botaneta/All-in-one-diybms/README.md

Modificación del proyecto original diyBms de Stuart Pittaway https://github.com/stuartpittaway/diyBMSv4<br>
Integración del módulo 490All-in-one y placa balanceadora en una sola pcb, con capacidad de balanceo de hasta 1.5A
