botaneta/All-in-one-diybms/Imagenes/photo_2024-06-24_20-07-30.jpg

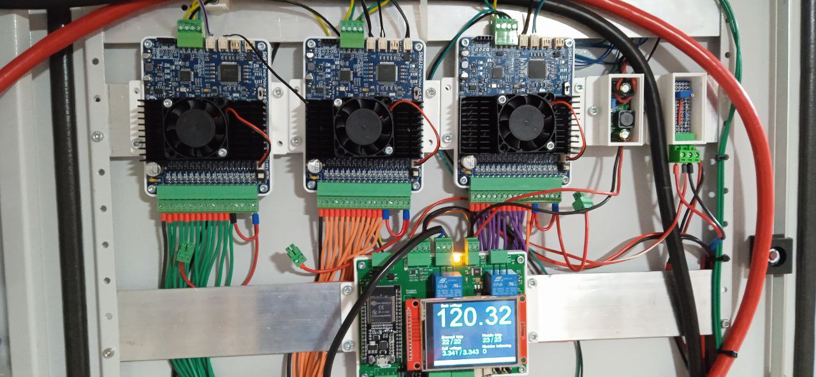
Imagenes/photo_2024-06-24_20-07-30.jpg
