botaneta/All-in-one-diybms/Soporte_3D/marco_all_in_one_1_5Abalancer.stl

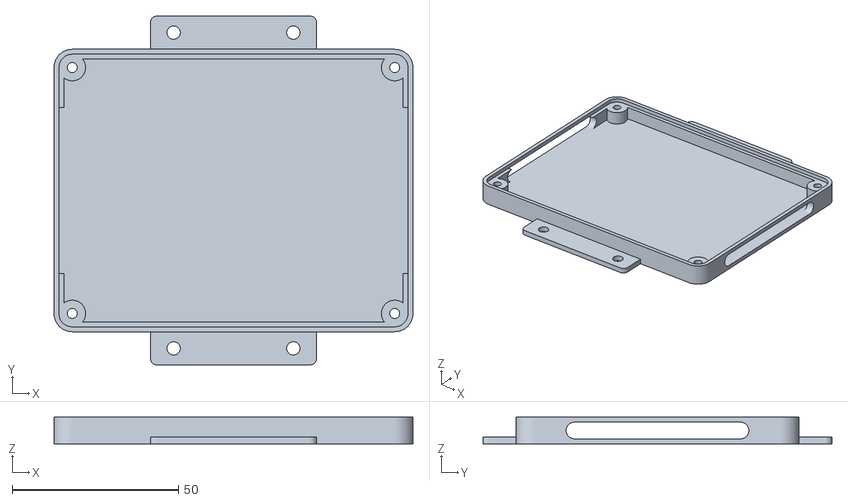
[picture p9: CAD file, 2024-06-24]
Soporte_3D/marco_all_in_one_1_5Abalancer.stl
108.0 x 105.0 x 8.00
