botaneta/All-in-one-diybms/(list of files, drawings)

Other design files:
KiCad_pcb/freerouting.dsn
