botaneta/All-in-one-diybms/KiCad_pcb/Module_16S.kicad_sch

## KiCad design KiCad_pcb/Module_16S.kicad_sch (2024-06-24)

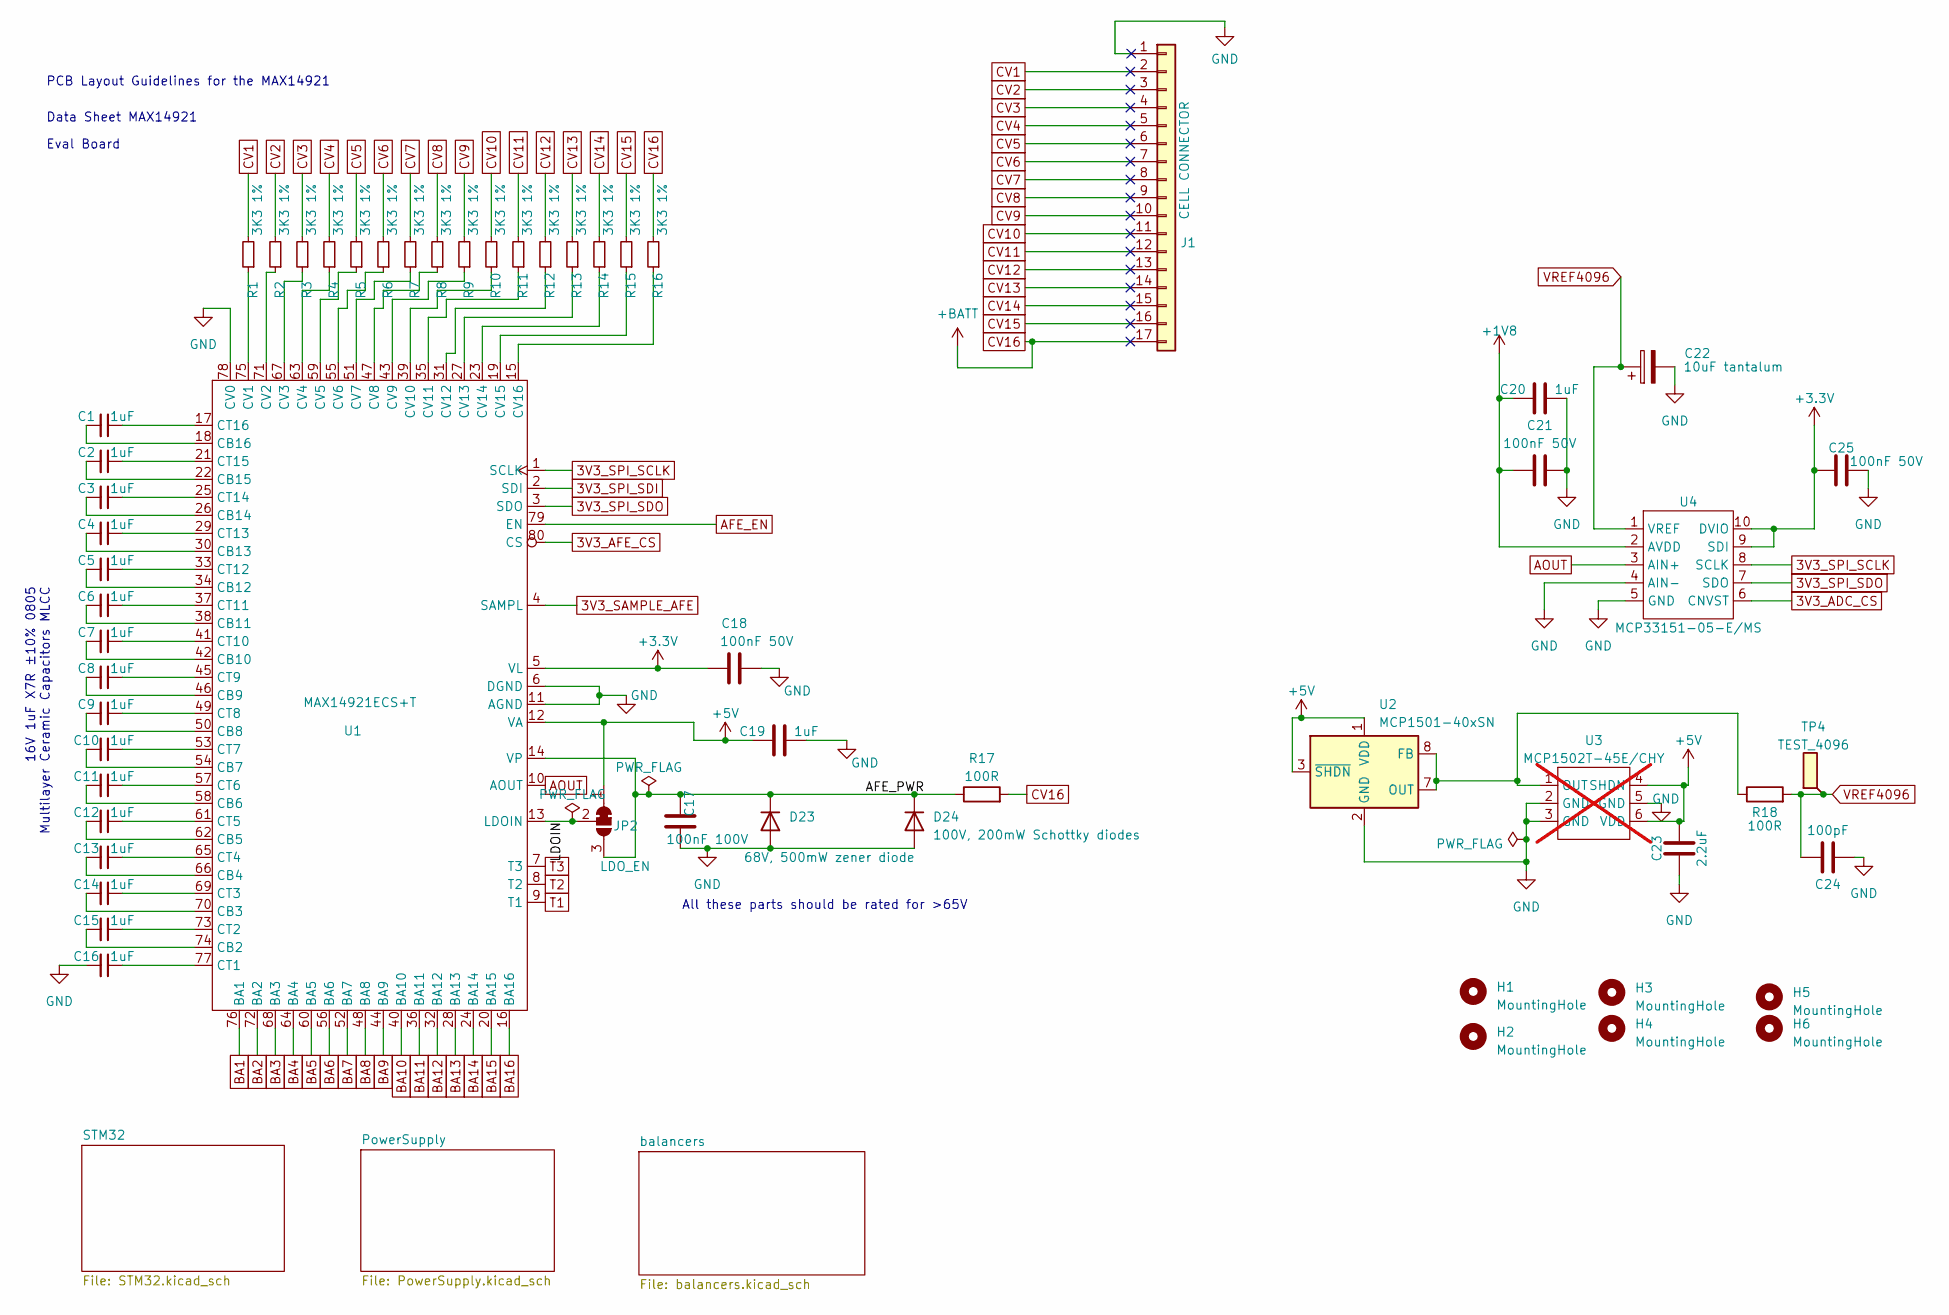
[picture p10: schematic Module_16S.kicad_sch]

Parts:
C1, C2, C3, C4, C5, C6, C7, C8, C9, C10, C11, C12, C13, C14, C15, C16, C19, C20: 1uF; C_0805_2012Metric; PartNumber CL21B105KBFNNNE; LCSCStockCode C28323
C17: 100nF 100V; C_0805_2012Metric; PartNumber CL21B104KCFNNNE; LCSCStockCode C28233
C18, C21, C25: 100nF 50V; C_0603_1608Metric; PartNumber CC0603KRX7R9BB104; LCSCStockCode C14663
C22: 10uF tantalum; CP_EIA-3216-18_Kemet-A; PartNumber TAJA106K016RNJ; LCSCStockCode C7171
C23: 2.2uF; C_0603_1608Metric; PartNumber CL10A225KO8NNNC; LCSCStockCode C23630
C24: 100pF; C_0603_1608Metric; PartNumber CL10C101JB8NNNC; LCSCStockCode C14858
D23: 68V, 500mW zener diode; D_SOD-123; PartNumber MMSZ5266BT1G; LCSCStockCode C242416
D24: 100V, 200mW Schottky diodes; D_SOD-123; PartNumber BAT46W-7-F; LCSCStockCode C83152
H1, H2: MountingHole; MountingHole_3.2mm_M3_DIN965_Pad
H3, H4, H5, H6: MountingHole; MountingHole_3.2mm_M3_ISO7380_Pad
J1: CELL CONNECTOR; WJ15EDGRC-3.81-17P; PartNumber WJ15EDGRC-3.81-17P; LCSCStockCode C489980
JP2: LDO_EN; SolderJumper-3_P1.3mm_Bridged12_RoundedPad1.0x1.5mm_NumberL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
R1, R2, R3, R4, R5, R6, R7, R8, R9, R10, R11, R12, R13, R14, R15, R16: 3K3 1%; R_0603_1608Metric; PartNumber 0603WAF3301T5E; LCSCStockCode C22978
R17, R18: 100R; R_0603_1608Metric; PartNumber 0603WAF1000T5E; LCSCStockCode C22775
TP4: TEST_4096; TestPoint_Pad_1.5x1.5mm
U1: MAX14921ECS+T; TQFP-80_12x12mm_P0.5mm; PartNumber MAX14921ECS+T; LCSCStockCode C2932577
U2: MCP1501-40xSN; SOIC-8_3.9x4.9mm_P1.27mm; PartNumber MCP1501-40E/SN; LCSCStockCode C1575589
U3: MCP1502T-45E/CHY; SOT-23-6; PartNumber MCP1502T-45E/CHY; not fitted
U4: MCP33151-05-E/MS; MSOP-10_3x3mm_P0.5mm; PartNumber MCP33151-05-E/MS; LCSCStockCode C635984

Connections:
3V3_ADC_CS: U4.6 (CNVST)
3V3_AFE_CS: U1.80 (CS)
3V3_SAMPLE_AFE: U1.4 (SAMPL)
3V3_SPI_SCLK: U1.1 (SCLK), U4.8 (SCLK)
3V3_SPI_SDI: U1.2 (SDI)
3V3_SPI_SDO: U1.3 (SDO), U4.7 (SDO)
+1V8: C20.1, C21.1, U4.2 (AVDD)
+3.3V: C18.1, C25.1, U1.5 (VL), U4.9 (SDI), U4.10 (DVIO)
+5V: C19.1, C23.2, JP2.1 (A), U1.12 (VA), U2.1 (VDD), U2.3 (~SHDN), U3.4 (SHDN), U3.6 (VDD)
+BATT: J1.17, R16.2, R17.2
AFE_EN: U1.79 (EN)
AFE_PWR: C17.1, D23.1 (K), D24.1 (K), JP2.3 (B), R17.1, U1.14 (VP)
AOUT: U1.10 (AOUT), U4.3 (AIN+)
BA1: U1.76 (BA1)
BA2: U1.72 (BA2)
BA3: U1.68 (BA3)
BA4: U1.64 (BA4)
BA5: U1.60 (BA5)
BA6: U1.56 (BA6)
BA7: U1.52 (BA7)
BA8: U1.48 (BA8)
BA9: U1.44 (BA9)
BA10: U1.40 (BA10)
BA11: U1.36 (BA11)
BA12: U1.32 (BA12)
BA13: U1.28 (BA13)
BA14: U1.24 (BA14)
BA15: U1.20 (BA15)
BA16: U1.16 (BA16)
CV1: J1.2, R1.2
CV2: J1.3, R2.2
CV3: J1.4, R3.2
CV4: J1.5, R4.2
CV5: J1.6, R5.2
CV6: J1.7, R6.2
CV7: J1.8, R7.2
CV8: J1.9, R8.2
CV9: J1.10, R9.2
CV10: J1.11, R10.2
CV11: J1.12, R11.2
CV12: J1.13, R12.2
CV13: J1.14, R13.2
CV14: J1.15, R14.2
CV15: J1.16, R15.2
GND: C16.2, C17.2, C18.2, C19.2, C20.2, C21.2, C22.2, C23.1, C24.1, C25.2, D23.2 (A), D24.2 (A), J1.1, U1.6 (DGND), U1.11 (AGND), U1.78 (CV0), U2.2 (GND), U2.4 (GND), U2.5 (GND), U2.6 (GND), U3.2 (GND), U3.3 (GND), U3.5 (GND), U4.4 (AIN-), U4.5 (GND)
LDOIN: JP2.2 (C), U1.13 (LDOIN)
unnamed: C1.1, U1.17 (CT16)
unnamed: C1.2, U1.18 (CB16)
unnamed: C2.1, U1.21 (CT15)
unnamed: C2.2, U1.22 (CB15)
unnamed: C3.1, U1.25 (CT14)
unnamed: C3.2, U1.26 (CB14)
unnamed: C4.1, U1.29 (CT13)
unnamed: C4.2, U1.30 (CB13)
unnamed: C5.1, U1.33 (CT12)
unnamed: C5.2, U1.34 (CB12)
unnamed: C6.1, U1.37 (CT11)
unnamed: C6.2, U1.38 (CB11)
unnamed: C7.1, U1.41 (CT10)
unnamed: C7.2, U1.42 (CB10)
unnamed: C8.1, U1.45 (CT9)
unnamed: C8.2, U1.46 (CB9)
unnamed: C9.1, U1.49 (CT8)
unnamed: C9.2, U1.50 (CB8)
unnamed: C10.1, U1.53 (CT7)
unnamed: C10.2, U1.54 (CB7)
unnamed: C11.1, U1.57 (CT6)
unnamed: C11.2, U1.58 (CB6)
unnamed: C12.1, U1.61 (CT5)
unnamed: C12.2, U1.62 (CB5)
unnamed: C13.1, U1.65 (CT4)
unnamed: C13.2, U1.66 (CB4)
unnamed: C14.1, U1.69 (CT3)
unnamed: C14.2, U1.70 (CB3)
unnamed: C15.1, U1.73 (CT2)
unnamed: C15.2, U1.74 (CB2)
unnamed: C16.1, U1.77 (CT1)
unnamed: R1.1, U1.75 (CV1)
unnamed: R2.1, U1.71 (CV2)
unnamed: R3.1, U1.67 (CV3)
unnamed: R4.1, U1.63 (CV4)
unnamed: R5.1, U1.59 (CV5)
unnamed: R6.1, U1.55 (CV6)
unnamed: R7.1, U1.51 (CV7)
unnamed: R8.1, U1.47 (CV8)
unnamed: R9.1, U1.43 (CV9)
unnamed: R10.1, U1.39 (CV10)
unnamed: R11.1, U1.35 (CV11)
unnamed: R12.1, U1.31 (CV12)
unnamed: R13.1, U1.27 (CV13)
unnamed: R14.1, U1.23 (CV14)
unnamed: R15.1, U1.19 (CV15)
unnamed: R16.1, U1.15 (CV16)
unnamed: R18.1, U2.7 (OUT), U2.8 (FB), U3.1 (OUT)
T1: U1.9 (T1)
T2: U1.8 (T2)
T3: U1.7 (T3)
VREF4096: C22.1, C24.2, R18.2, TP4.1, U4.1 (VREF)

Notes on the sheet:
All these parts should be rated for >65V
Eval Board
16V 1uF X7R ±10% 0805 Multilayer Ceramic Capacitors MLCC
Data Sheet MAX14921
PCB Layout Guidelines for the MAX14921
