botaneta/All-in-one-diybms/KiCad_pcb/PowerSupply.kicad_sch

## KiCad design KiCad_pcb/PowerSupply.kicad_sch (2024-06-24)

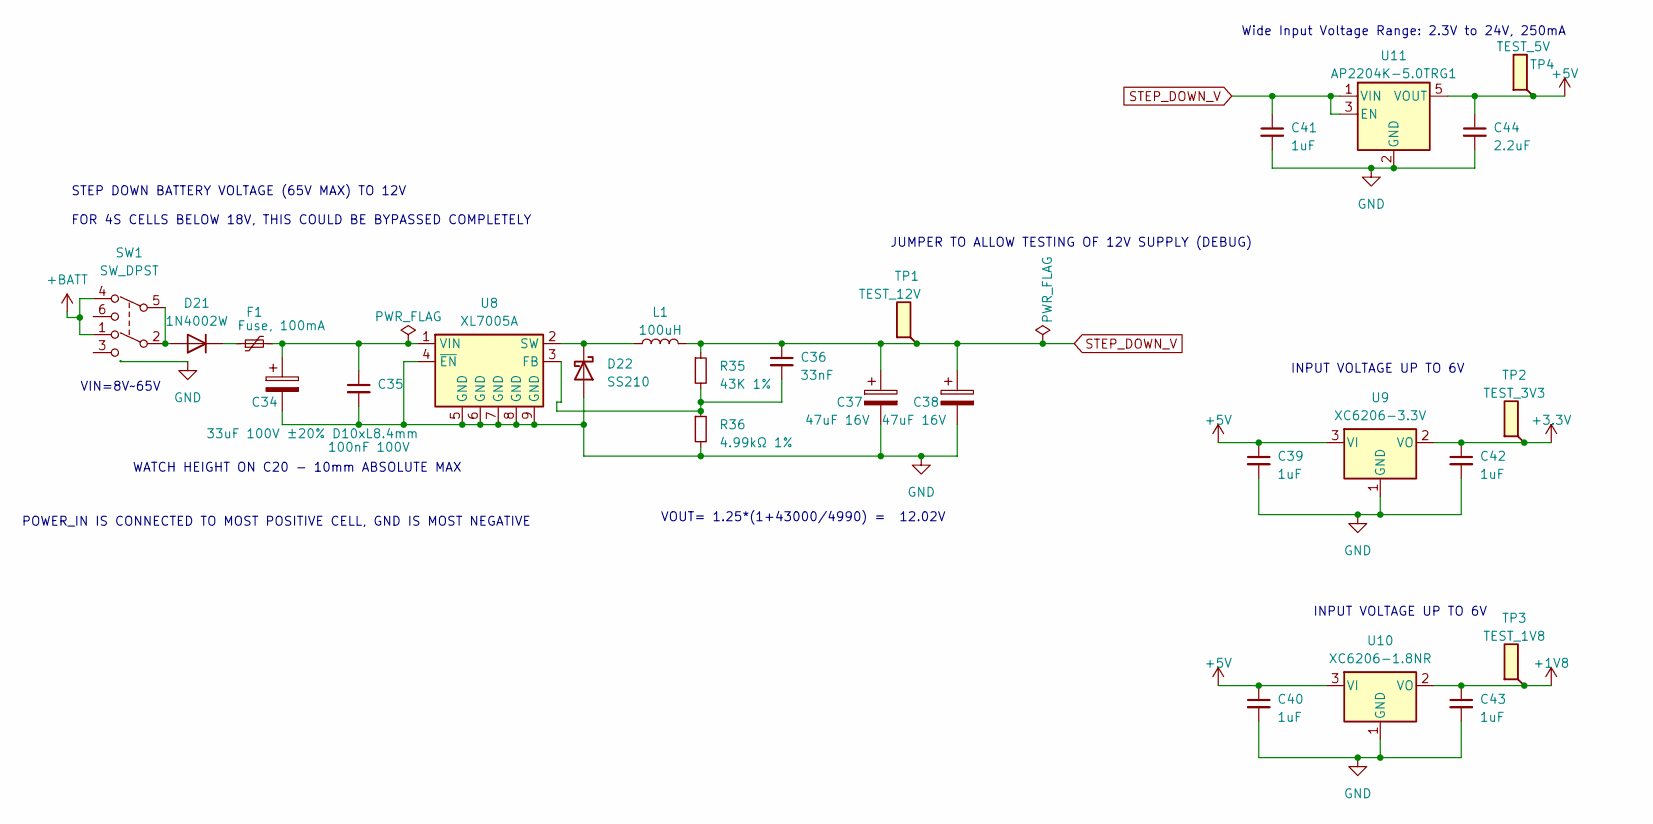
[picture p11: schematic PowerSupply.kicad_sch]

Parts:
C34: 33uF 100V ±20% D10xL8.4mm; CP_Elec_10x7.9; PartNumber VK7E0842A330MV; LCSCStockCode C486954
C35: 100nF 100V; C_0805_2012Metric; PartNumber CL21B104KCFNNNE; LCSCStockCode C28233
C36: 33nF; C_0603_1608Metric; PartNumber CC0603KRX7R8BB333; LCSCStockCode C113810
C37, C38: 47uF 16V; CP_Elec_5x5.4; PartNumber RVT1C470M0505; LCSCStockCode C3337
C39, C40, C41, C42, C43: 1uF; C_0805_2012Metric; PartNumber CL21B105KBFNNNE; LCSCStockCode C28323
C44: 2.2uF; C_0603_1608Metric; PartNumber CL10A225KO8NNNC; LCSCStockCode C23630
D21: 1N4002W; D_SOD-123F; PartNumber 1N4002W; LCSCStockCode C169542
D22: SS210; D_SMA; PartNumber SS210; LCSCStockCode C432298
F1: Fuse, 100mA; Fuse_Bourns_MF-RHT100; PartNumber JK250-100U; LCSCStockCode C2680606
L1: 100uH; L_Changjiang_FNR5020S; PartNumber SMNR5020-101MT; LCSCStockCode C135286
R35: 43K 1%; R_0603_1608Metric; PartNumber 0603WAF4302T5E; LCSCStockCode C23172
R36: 4.99kΩ 1%; R_0603_1608Metric; PartNumber 0603WAF4991T5E; LCSCStockCode C23046
SW1: SW_DPST; SW_Push_2P2T_Toggle_G_swicht; PartNumber PS-7054DVB-6PL; LCSCStockCode C22363819
TP1: TEST_12V; TestPoint_Pad_1.5x1.5mm
TP2: TEST_3V3; TestPoint_Pad_1.5x1.5mm
TP3: TEST_1V8; TestPoint_Pad_1.5x1.5mm
TP4: TEST_5V; TestPoint_Pad_1.5x1.5mm
U8: XL7005A; SOIC-8-1EP_3.9x4.9mm_P1.27mm_EP2.29x3mm; PartNumber XL7005A; LCSCStockCode C50848
U9: XC6206-3.3V; SOT-23-3; PartNumber XC6206-3.3V; LCSCStockCode C2891841
U10: XC6206-1.8NR; SOT-23-3; PartNumber XC6206-1.8NR; LCSCStockCode C2984870
U11: AP2204K-5.0TRG1; SOT-23-5; PartNumber AP2204K-5.0TRG1; LCSCStockCode C112031

Connections:
+1V8: C43.1, TP3.1, U10.2 (VO)
+3.3V: C42.1, TP2.1, U9.2 (VO)
+5V: C39.1, C40.1, C44.1, TP4.1, U9.3 (VI), U10.3 (VI), U11.5 (VOUT)
+BATT: SW1.1, SW1.4
GND: C34.2, C35.2, C37.2, C38.2, C39.2, C40.2, C41.2, C42.2, C43.2, C44.2, D22.2 (A), R36.2, U8.4 (~EN), U8.5 (GND), U8.6 (GND), U8.7 (GND), U8.8 (GND), U8.9 (GND), U9.1 (GND), U10.1 (GND), U11.2 (GND)
unnamed: C34.1, C35.1, F1.2, U8.1 (VIN)
unnamed: C36.2, R35.2, R36.1, U8.3 (FB)
unnamed: D21.1 (K), F1.1
unnamed: D21.2 (A), SW1.2, SW1.5
unnamed: D22.1 (K), L1.1, U8.2 (SW)
STEP_DOWN_V: C36.1, C37.1, C38.1, C41.1, L1.2, R35.1, TP1.1, U11.1 (VIN), U11.3 (EN)

Notes on the sheet:
INPUT VOLTAGE UP TO 6V
POWER_IN IS CONNECTED TO MOST POSITIVE CELL, GND IS MOST NEGATIVE
JUMPER TO ALLOW TESTING OF 12V SUPPLY (DEBUG)
VIN=8V~65V
STEP DOWN BATTERY VOLTAGE (65V MAX) TO 12V FOR 4S CELLS BELOW 18V, THIS COULD BE BYPASSED COMPLETELY
WATCH HEIGHT ON C20 - 10mm ABSOLUTE MAX
VOUT= 1.25*(1+43000/4990) = 12.02V
Wide Input Voltage Range: 2.3V to 24V, 250mA
