botaneta/All-in-one-diybms/KiCad_pcb/STM32.kicad_sch

## KiCad design KiCad_pcb/STM32.kicad_sch (2024-06-24)

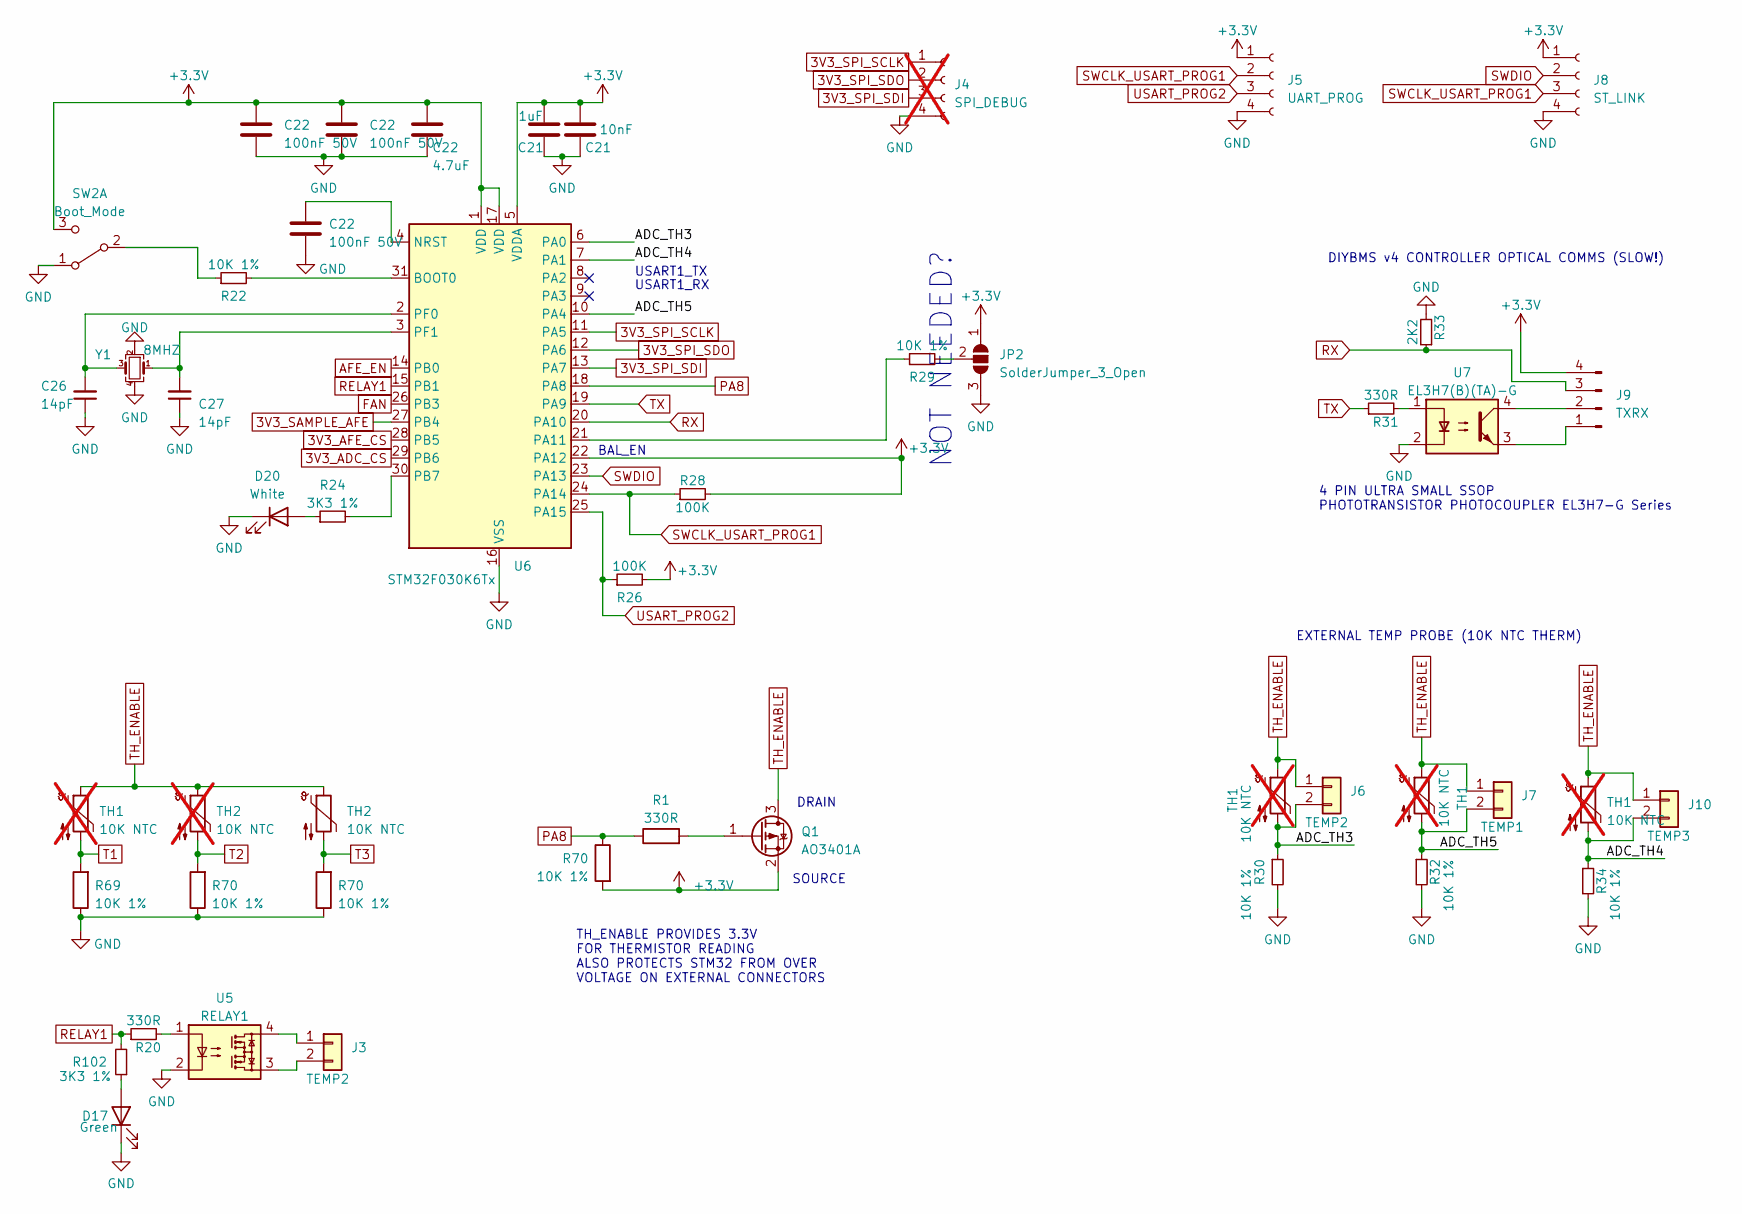
[picture p12: schematic STM32.kicad_sch]

Parts:
C21: 1uF; C_0805_2012Metric; PartNumber CL21B105KBFNNNE; LCSCStockCode C28323
C22: 100nF 50V; C_0603_1608Metric; PartNumber CC0603KRX7R9BB104; LCSCStockCode C14663
C26, C27: 14pF; C_0805_2012Metric; PartNumber CC0805JRNPO9BN140; LCSCStockCode C519919
D17: Green; LED_0603_1608Metric; LCSCStockCode C2286
D20: White; LED_0603_1608Metric; LCSCStockCode C2290
J3, J6: TEMP2; JST_PH_S2B-PH-K_1x02_P2.00mm_Horizontal; PartNumber S2B-PH-K(LF)(SN); LCSCStockCode C265016
J4: SPI_DEBUG; PinSocket_1x04_P2.00mm_Vertical; PartNumber C2718488; LCSCStockCode C2718488; not fitted
J5: UART_PROG; PinSocket_1x04_P2.54mm_Vertical; PartNumber PM254-1-04-W-8.5; LCSCStockCode C2897386
J7: TEMP1; JST_PH_S2B-PH-K_1x02_P2.00mm_Horizontal; PartNumber S2B-PH-K(LF)(SN); LCSCStockCode C265016
J8: ST_LINK; PinSocket_1x04_P2.54mm_Vertical; PartNumber PM254-1-04-W-8.5; LCSCStockCode C2897386
J9: TXRX; PhoenixContact_MC_1,5_4-G-3.81_1x04_P3.81mm_Horizontal; PartNumber WJ15EDGRC-3.81-4P; LCSCStockCode C7245
J10: TEMP3; JST_PH_S2B-PH-K_1x02_P2.00mm_Horizontal; PartNumber S2B-PH-K(LF)(SN); LCSCStockCode C265016
JP2: SolderJumper_3_Open; SolderJumper-3_P1.3mm_Open_Pad1.0x1.5mm_NumberLabels
Q1: AO3401A; SOT-23; PartNumber AO3401A; LCSCStockCode C15127
R1, R20, R31: 330R; R_0603_1608Metric; PartNumber 0603WAF3300T5E; LCSCStockCode C23138
R22, R29, R30, R32, R34, R69, R70: 10K 1%; R_0603_1608Metric; PartNumber 0603WAF1002T5E; LCSCStockCode C25804
R24, R102: 3K3 1%; R_0603_1608Metric; PartNumber 0603WAF3301T5E; LCSCStockCode C22978
R26, R28: 100K; R_0603_1608Metric; PartNumber 0603WAF1003T5E; LCSCStockCode C25803
R33: 2K2; R_0603_1608Metric; PartNumber 0603WAF2201T5E; LCSCStockCode C4190
SW2: Boot_Mode; PinHeader_1x03_P2.54mm_Vertical; PartNumber SK-3260D-01-L1; LCSCStockCode C466004
TH1: 10K NTC; R_0805_2012Metric; PartNumber CMFB103F3950FANT; LCSCStockCode C51597; not fitted
TH2: 10K NTC; R_0805_2012Metric; PartNumber CMFB103F3950FANT; LCSCStockCode C51597
U5: RELAY1; SO-4_4.4x4.3mm_P2.54mm; PartNumber LT219-3; LCSCStockCode C2691603
U6: STM32F030K6Tx; LQFP-32_7x7mm_P0.8mm; PartNumber STM32F030K6T6; LCSCStockCode C46830
U7: EL3H7(B)(TA)-G; SOP-4_4.4x2.6mm_P1.27mm; PartNumber EL3H7(B)(TA)-G; LCSCStockCode C32565
Y1: 8MHZ; Crystal_SMD_3225-4Pin_3.2x2.5mm; PartNumber TAXM8M4RDBCCT2T; LCSCStockCode C400090

Connections:
3V3_ADC_CS: U6.29 (PB6)
3V3_AFE_CS: U6.28 (PB5)
3V3_SAMPLE_AFE: U6.27 (PB4)
3V3_SPI_SCLK: J4.1, U6.11 (PA5)
3V3_SPI_SDI: J4.3, U6.13 (PA7)
3V3_SPI_SDO: J4.2, U6.12 (PA6)
+3.3V: C21.2, C22.2, J5.1, J8.1, J9.4, JP2.1 (A), Q1.2 (S), R26.2, R28.2, R70.2, SW2.3 (C), U6.1 (VDD), U6.5 (VDDA), U6.17 (VDD), U6.22 (PA12)
ADC_TH3: J6.2, R30.1, TH1.2, U6.6 (PA0)
ADC_TH4: J10.2, R34.1, TH1.2, U6.7 (PA1)
ADC_TH5: J7.2, R32.1, TH1.2, U6.10 (PA4)
AFE_EN: U6.14 (PB0)
FAN: U6.26 (PB3)
GND: C21.1, C22.1, C26.1, C27.1, D17.1 (K), D20.1 (K), J4.4, J5.4, J8.4, JP2.3 (B), R30.2, R32.2, R33.2, R34.2, R69.1, R70.1, SW2.1 (A), U5.2, U6.16 (VSS), U6.32 (VSS), U7.2, Y1.2, Y1.4
unnamed: C22.2, U6.4 (NRST)
unnamed: C26.2, U6.2 (PF0), Y1.3
unnamed: C27.2, U6.3 (PF1), Y1.1
unnamed: D17.2 (A), R102.1
unnamed: D20.2 (A), R24.1
unnamed: J3.1, U5.4
unnamed: J3.2, U5.3
unnamed: J9.1, U7.3
unnamed: J9.2, U7.4
unnamed: JP2.2 (C), R29.2
unnamed: Q1.1 (G), R1.2
unnamed: R20.2, U5.1
unnamed: R22.1, SW2.2 (B)
unnamed: R22.2, U6.31 (BOOT0)
unnamed: R24.2, U6.30 (PB7)
unnamed: R29.1, U6.21 (PA11)
unnamed: R31.2, U7.1
PA8: R1.1, R70.1, U6.18 (PA8)
RELAY1: R20.1, R102.2, U6.15 (PB1)
RX: J9.3, R33.1, U6.20 (PA10)
SWCLK_USART_PROG1: J5.2, J8.3, R28.1, U6.24 (PA14)
SWDIO: J8.2, U6.23 (PA13)
T1: R69.2, TH1.2
T2: R70.2, TH2.2
T3: R70.2, TH2.2
TH_ENABLE: J6.1, J7.1, J10.1, Q1.3 (D), TH1.1, TH2.1
TX: R31.1, U6.19 (PA9)
USART_PROG2: J5.3, R26.1, U6.25 (PA15)

Notes on the sheet:
4 PIN ULTRA SMALL SSOP PHOTOTRANSISTOR PHOTOCOUPLER EL3H7-G Series
SOURCE
USART1_RX
DIYBMS v4 CONTROLLER OPTICAL COMMS (SLOW!)
BAL_EN
TH_ENABLE PROVIDES 3.3V FOR THERMISTOR READING ALSO PROTECTS STM32 FROM OVER VOLTAGE ON EXTERNAL CONNECTORS
NOT NEEDED?
DRAIN
EXTERNAL TEMP PROBE (10K NTC THERM)
USART1_TX
