botaneta/All-in-one-diybms/KiCad_pcb/balancers.kicad_sch_1A.kicad_sch

## KiCad design KiCad_pcb/balancers.kicad_sch_1A.kicad_sch (2024-06-24)

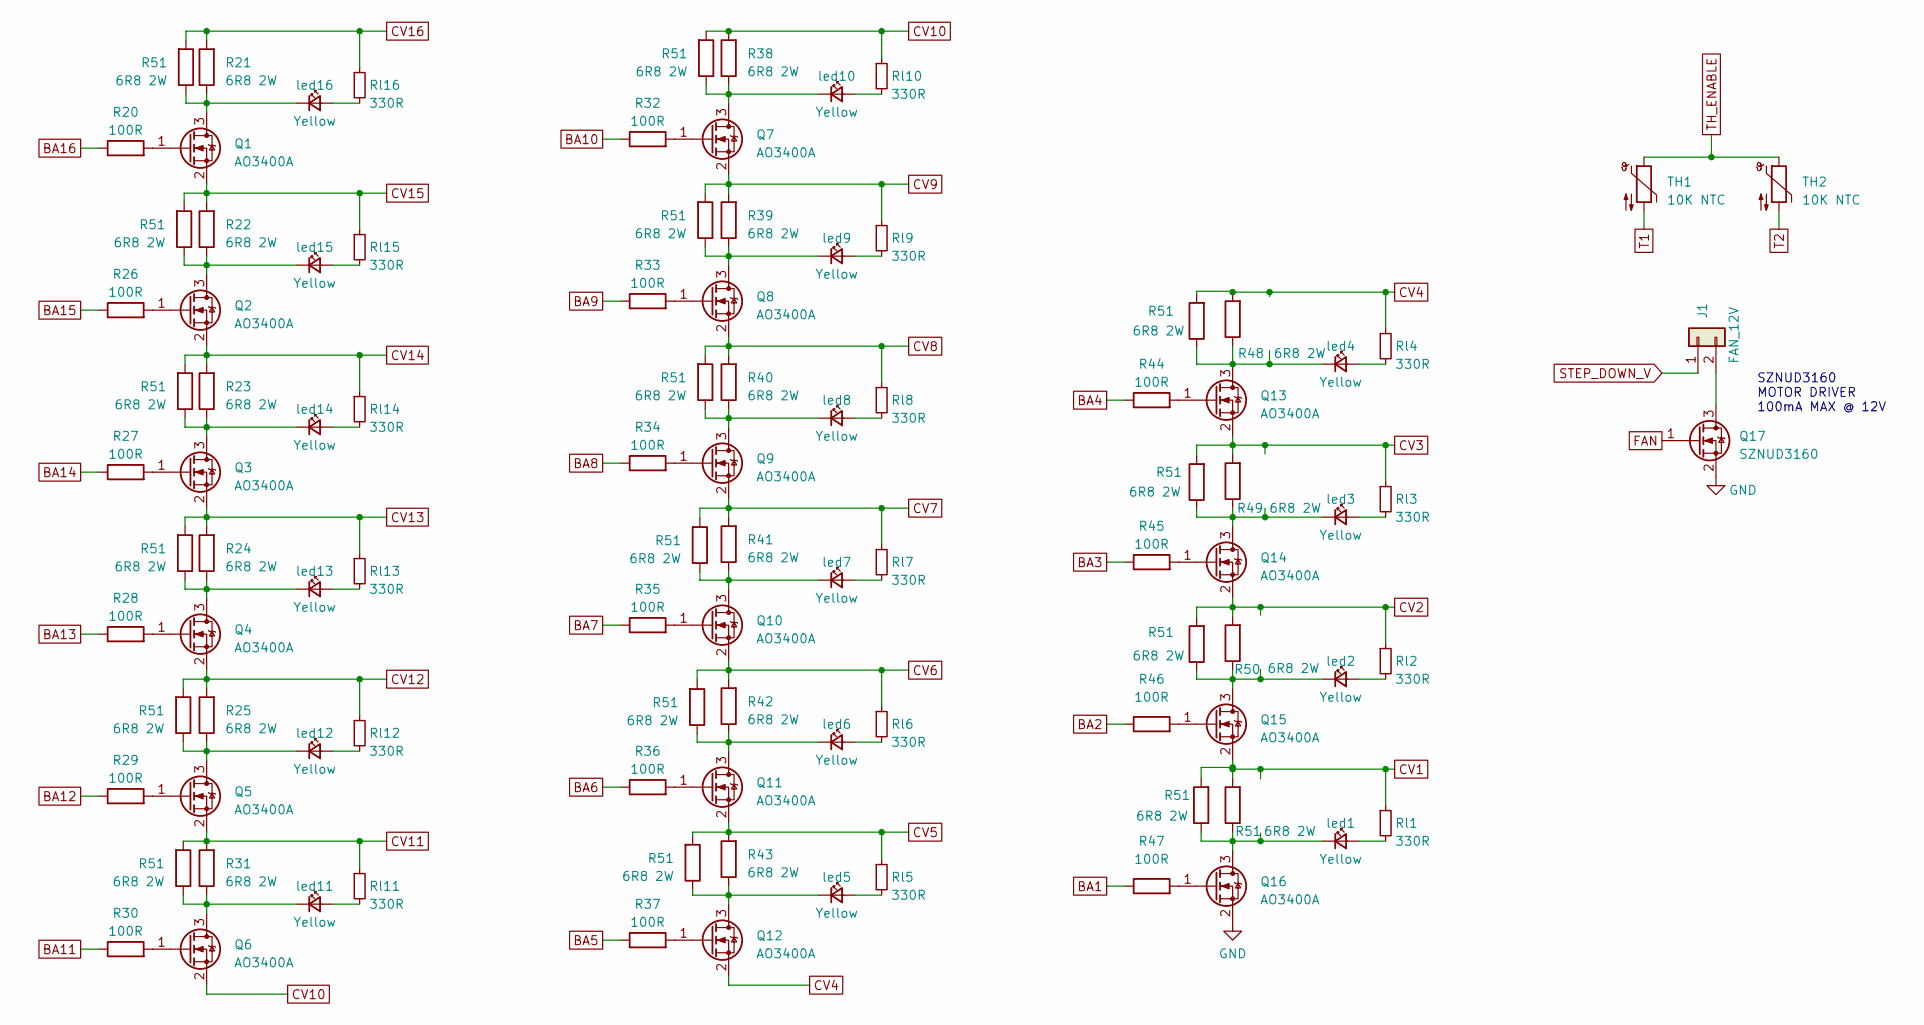
[picture p14: schematic balancers.kicad_sch_1A.kicad_sch]

Parts:
J1: FAN_12V; JST_PH_B2B-PH-K_1x02_P2.00mm_Vertical; PartNumber S2B-PH-K(LF)(SN); LCSCStockCode C265016
Q1, Q2, Q3, Q4, Q5, Q6, Q7, Q8, Q9, Q10, Q11, Q12, Q13, Q14, Q15, Q16: AO3400A; SOT-23; PartNumber AO3400A; LCSCStockCode C347475
Q17: SZNUD3160; SOT-23; PartNumber SZNUD3160LT1G; LCSCStockCode C894717
R20, R26, R27, R28, R29, R30, R32, R33, R34, R35, R36, R37, R44, R45, R46, R47: 100R; R_0603_1608Metric; PartNumber 0603WAF1000T5E; LCSCStockCode C22775
R21, R22, R23, R24, R25, R31, R38, R39, R40, R41, R42, R43, R48, R49, R50, R51: 6R8 2W; R_2512_6332Metric; PartNumber CRH2512J18R0E04Z; LCSCStockCode C2941596
Rl1, Rl2, Rl3, Rl4, Rl5, Rl6, Rl7, Rl8, Rl9, Rl10, Rl11, Rl12, Rl13, Rl14, Rl15, Rl16: 330R; R_0603_1608Metric; PartNumber 0603WAF3300T5E; LCSCStockCode C23138
TH1, TH2: 10K NTC; R_0805_2012Metric; PartNumber CMFB103F3950FANT; LCSCStockCode C51597
led1, led2, led3, led4, led5, led6, led7, led8, led9, led10, led11, led12, led13, led14, led15, led16: Yellow; LED_0603_1608Metric; PartNumber 19-213/Y2C-CQ2R2L/3T(CY); LCSCStockCode C72038

Connections:
BA1: R47.1
BA2: R46.1
BA3: R45.1
BA4: R44.1
BA5: R37.1
BA6: R36.1
BA7: R35.1
BA8: R34.1
BA9: R33.1
BA10: R32.1
BA11: R30.1
BA12: R29.1
BA13: R28.1
BA14: R27.1
BA15: R26.1
BA16: R20.1
CV1: Q15.2 (S), R51.2, Rl1.1
CV2: Q14.2 (S), R50.2, R51.2, Rl2.1
CV3: Q13.2 (S), R49.2, R51.2, Rl3.1
CV4: Q12.2 (S), R48.2, R51.2, Rl4.1
CV5: Q11.2 (S), R43.2, R51.2, Rl5.1
CV6: Q10.2 (S), R42.2, R51.2, Rl6.1
CV7: Q9.2 (S), R41.2, R51.2, Rl7.1
CV8: Q8.2 (S), R40.2, R51.2, Rl8.1
CV9: Q7.2 (S), R39.2, R51.2, Rl9.1
CV10: Q6.2 (S), R38.2, R51.2, Rl10.1
CV11: Q5.2 (S), R31.2, R51.2, Rl11.1
CV12: Q4.2 (S), R25.2, R51.2, Rl12.1
CV13: Q3.2 (S), R24.2, R51.2, Rl13.1
CV14: Q2.2 (S), R23.2, R51.2, Rl14.1
CV15: Q1.2 (S), R22.2, R51.2, Rl15.1
CV16: R21.2, R51.2, Rl16.1
FAN: Q17.1 (G)
GND: Q16.2 (S), Q17.2 (S)
unnamed: J1.2, Q17.3 (D)
unnamed: Q1.1 (G), R20.2
unnamed: Q1.3 (D), R21.1, R51.1, led16.1 (K)
unnamed: Q2.1 (G), R26.2
unnamed: Q2.3 (D), R22.1, R51.1, led15.1 (K)
unnamed: Q3.1 (G), R27.2
unnamed: Q3.3 (D), R23.1, R51.1, led14.1 (K)
unnamed: Q4.1 (G), R28.2
unnamed: Q4.3 (D), R24.1, R51.1, led13.1 (K)
unnamed: Q5.1 (G), R29.2
unnamed: Q5.3 (D), R25.1, R51.1, led12.1 (K)
unnamed: Q6.1 (G), R30.2
unnamed: Q6.3 (D), R31.1, R51.1, led11.1 (K)
unnamed: Q7.1 (G), R32.2
unnamed: Q7.3 (D), R38.1, R51.1, led10.1 (K)
unnamed: Q8.1 (G), R33.2
unnamed: Q8.3 (D), R39.1, R51.1, led9.1 (K)
unnamed: Q9.1 (G), R34.2
unnamed: Q9.3 (D), R40.1, R51.1, led8.1 (K)
unnamed: Q10.1 (G), R35.2
unnamed: Q10.3 (D), R41.1, R51.1, led7.1 (K)
unnamed: Q11.1 (G), R36.2
unnamed: Q11.3 (D), R42.1, R51.1, led6.1 (K)
unnamed: Q12.1 (G), R37.2
unnamed: Q12.3 (D), R43.1, R51.1, led5.1 (K)
unnamed: Q13.1 (G), R44.2
unnamed: Q13.3 (D), R48.1, R51.1, led4.1 (K)
unnamed: Q14.1 (G), R45.2
unnamed: Q14.3 (D), R49.1, R51.1, led3.1 (K)
unnamed: Q15.1 (G), R46.2
unnamed: Q15.3 (D), R50.1, R51.1, led2.1 (K)
unnamed: Q16.1 (G), R47.2
unnamed: Q16.3 (D), R51.1, led1.1 (K)
unnamed: Rl1.2, led1.2 (A)
unnamed: Rl2.2, led2.2 (A)
unnamed: Rl3.2, led3.2 (A)
unnamed: Rl4.2, led4.2 (A)
unnamed: Rl5.2, led5.2 (A)
unnamed: Rl6.2, led6.2 (A)
unnamed: Rl7.2, led7.2 (A)
unnamed: Rl8.2, led8.2 (A)
unnamed: Rl9.2, led9.2 (A)
unnamed: Rl10.2, led10.2 (A)
unnamed: Rl11.2, led11.2 (A)
unnamed: Rl12.2, led12.2 (A)
unnamed: Rl13.2, led13.2 (A)
unnamed: Rl14.2, led14.2 (A)
unnamed: Rl15.2, led15.2 (A)
unnamed: Rl16.2, led16.2 (A)
STEP_DOWN_V: J1.1
T1: TH1.2
T2: TH2.2
TH_ENABLE: TH1.1, TH2.1

Notes on the sheet:
SZNUD3160 MOTOR DRIVER 100mA MAX @ 12V
